conk3r353/YA-SDVX-Con/manufacturing/BOM_YASDVXCon.csv

No. | Quantity | Comment | Designator | Footprint | Value | Manufacturer Part | Manufacturer | Supplier Part | Supplier
1 | 7 | MX1A-11NW | A_BT,B_BT,C_BT,D_BT,FX_L_BT,FX_R_BT,START_BT | SW-TH_MX1A-11NW |  | MX1A-11NW | CHERRY | C3316924 | LCSC
2 | 12 | 100nF | C20,C21,C24,C25,C26,C29,C30,C31,C32,C33,C34,C35 | C0402 | 100nF | CL05B104KO5NNNC | SAMSUNG(三星) | C1525 | LCSC
3 | 2 | 4.7uF | C22,C27 | C0603 | 4.7uF | CL10A475KO8NNNC | SAMSUNG(三星) | C19666 | LCSC
4 | 2 | 1uF | C23,C38 | C0402 | 1uF | CL05A105KA5NQNC | SAMSUNG(三星) | C52923 | LCSC
5 | 1 | 4.7nF | C28 | C1206 | 4.7nF | C1206N472J501TEF | IHHEC(禾伸堂) | C2991917 | LCSC
6 | 2 | 18pF | C36,C37 | C0402 | 18pF | 0402CG180J500NT | FH(风华) | C1549 | LCSC
7 | 1 | USBLC6-2P6 | D2 | SOT-666-6_L1.6-W1.2-P0.50-LS1.6-BR |  | USBLC6-2P6 | ST(意法半导体) | C15999 | LCSC
8 | 1 | HX PH254-01-06-Z-L11.5 through hole header | H1 | HDR-TH_6P-P2.54-V-M |  | HX PH254-01-06-Z-L11.5 through hole header | hanxia(韩下) | C52016393 | LCSC
9 | 1 | GZ2012D601TF | L2 | L0805 |  | GZ2012D601TF | Sunlord(顺络) | C1017 | LCSC
10 | 4 | F.1206.00029/P2-1206B1TS2-09T-201 | LED1,LED2,LED3,LED4 | LED1206-RD |  | F.1206.00029/P2-1206B1TS2-09T-201 | TUOZHAN(拓展光电) | C7496849 | LCSC
11 | 4 | 470Ω | R16,R17,R18,R19 | R0402 | 470Ω | 0402WGF4700TCE | UNI-ROYAL(厚声) | C25117 | LCSC
12 | 3 | 560Ω | R20,R21,R22 | R0603 | 560Ω | 0603WAF5600T5E | UNI-ROYAL(厚声) | C23204 | LCSC
13 | 9 | 10kΩ | R23,R24,R25,R26,R27,R28,R31,R32,R37 | R0402 | 10kΩ | 0402WGF1002TCE | UNI-ROYAL(厚声) | C25744 | LCSC
14 | 2 | 5.1kΩ | R29,R33 | R0402 | 5.1kΩ | 0402WGF5101TCE | UNI-ROYAL(厚声) | C25905 | LCSC
15 | 2 | 22Ω | R30,R34 | R0402 | 22Ω | 0402WGF220JTCE | UNI-ROYAL(厚声) | C25092 | LCSC
16 | 1 | 1MΩ | R35 | R0402 | 1MΩ | 0402WGF1004TCE | UNI-ROYAL(厚声) | C26083 | LCSC
17 | 1 | 1.5kΩ | R36 | R0402 | 1.5kΩ | 0402WGF1501TCE | UNI-ROYAL(厚声) | C25867 | LCSC
18 | 1 | TBD62003AFNG,EL | U8 | SSOP-16_L4.9-W3.9-P0.64-LS6.0-BL |  | TBD62003AFNG,EL | TOSHIBA(东芝) | C150145 | LCSC
19 | 3 | F.1206.00003/P2-1206R1TS2-09T-001 | U10,U11,U12 | LED1206-RD |  | F.1206.00003/P2-1206R1TS2-09T-001 | TUOZHAN(拓展光电) | C7496845 | LCSC
20 | 1 | AP2112K-3.3TRG1 | U15 | SOT-25-5_L2.9-W1.6-P0.95-LS2.8-BL |  | AP2112K-3.3TRG1 | DIODES(美台) | C51118 | LCSC
21 | 1 | STM32F303RET6 | U16 | LQFP-64_L10.0-W10.0-P0.50-LS12.0-BL |  | STM32F303RET6 | ST(意法半导体) | C183214 | LCSC
22 | 1 | TYPE-C-31-M-12 | USBC2 | USB-C_SMD-TYPE-C-31-M-12_1 |  | TYPE-C-31-M-12 | 韩国韩荣 | C165948 | LCSC
23 | 2 | PEC16-4020F-N0024 | VOL_L,VOL_R | SW-SMD_PEC16-4120F-N0012 |  | PEC16-4020F-N0024 | BOURNS | C22402301 | JLCPCB
24 | 1 | 8MHz | X2 | CRYSTAL-SMD_4P-L3.2-W2.5-BL | 8MHz | X32258MOB4SI | YXC(扬兴晶振) | C2682775 | LCSC
