conk3r353/YA-SDVX-Con/manufacturing/case/pcb_case_plates_1-3.dxf

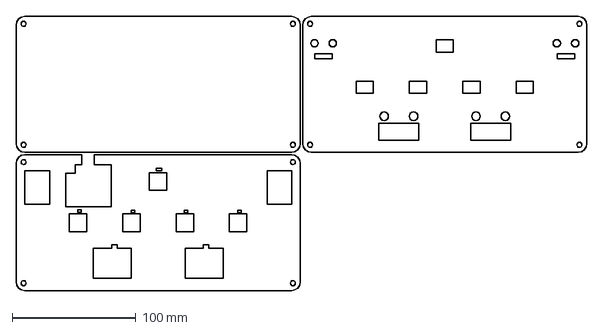
[picture p3: CAD file, 2026-09-15]
manufacturing/case/pcb_case_plates_1-3.dxf
462.0 x 222.0 mm
