conk3r353/YA-SDVX-Con/manufacturing/case/pcb_case_plates_extra_info.dxf

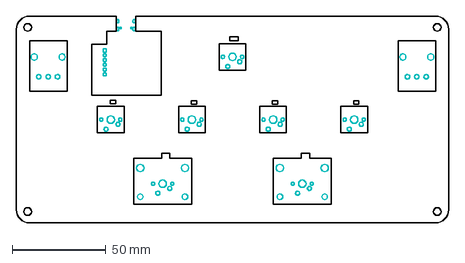
[picture p4: CAD file, 2026-09-15]
manufacturing/case/pcb_case_plates_extra_info.dxf
230.0 x 110.0 mm
