conk3r353/YA-SDVX-Con/manufacturing/case/pcb_case_plate_4.dxf

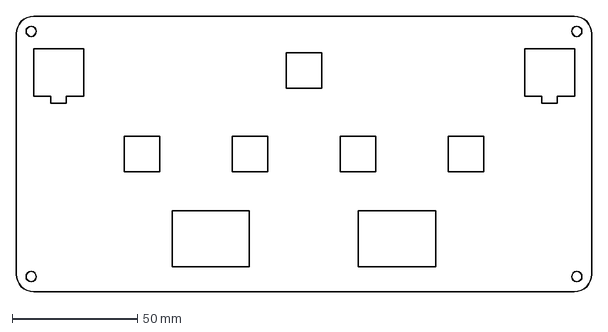
[picture p5: CAD file, 2026-09-13]
manufacturing/case/pcb_case_plate_4.dxf
230.0 x 110.0 mm
