conk3r353/YA-SDVX-Con/software/Core/Src/main.c

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
/* Includes ------------------------------------------------------------------*/
#include "main.h"
#include "usb_device.h"

/* USER CODE BEGIN Includes */
#include "usbd_customhid.h"
#include "Button.h"
/* USER CODE END Includes */

TIM_HandleTypeDef htim2;
TIM_HandleTypeDef htim3;

UART_HandleTypeDef huart2;

/* USER CODE BEGIN PV */
extern PCD_HandleTypeDef hpcd_USB_FS;
extern USBD_HandleTypeDef hUsbDeviceFS;

volatile uint16_t vol_l_counter = 0;
volatile uint16_t vol_r_counter = 0;

volatile Button bt_a;
volatile Button bt_b;
volatile Button bt_c;
volatile Button bt_d;
volatile Button bt_fx_l;
volatile Button bt_fx_r;
volatile Button bt_start;

volatile GPIO_PinState bt_a_state = GPIO_PIN_RESET;
volatile GPIO_PinState bt_b_state = GPIO_PIN_RESET;
volatile GPIO_PinState bt_c_state = GPIO_PIN_RESET;
volatile GPIO_PinState bt_d_state = GPIO_PIN_RESET;
volatile GPIO_PinState bt_fx_l_state = GPIO_PIN_RESET;
volatile GPIO_PinState bt_fx_r_state = GPIO_PIN_RESET;
volatile GPIO_PinState bt_start_state = GPIO_PIN_RESET;

typedef struct __attribute__((packed)) {
    uint8_t report_id;
    uint16_t buttons;
    uint8_t vol_l_encoder;
    uint8_t vol_r_encoder;
} HID_Report_t;

HID_Report_t hid_report = {0};
/* USER CODE END PV */

void SystemClock_Config(void);
static void MX_GPIO_Init(void);
static void MX_USART2_UART_Init(void);
static void MX_TIM2_Init(void);
static void MX_TIM3_Init(void);
/**
  * @brief  The application entry point.
  * @retval int
  */
int main(void)
{

  /* MCU Configuration--------------------------------------------------------*/

  /* Reset of all peripherals, Initializes the Flash interface and the Systick. */
  HAL_Init();

  /* Configure the system clock */
  SystemClock_Config();

  /* Initialize all configured peripherals */
  MX_GPIO_Init();
  MX_USART2_UART_Init();
  MX_TIM2_Init();
  MX_TIM3_Init();

  MX_USB_DEVICE_Init();
  /* USER CODE BEGIN 2 */

  HAL_TIM_Encoder_Start(&htim2, TIM_CHANNEL_ALL);
  HAL_TIM_Encoder_Start(&htim3, TIM_CHANNEL_ALL);

  bt_a = Button_Init(DEFAULT_DEBOUNCE);
  bt_b = Button_Init(DEFAULT_DEBOUNCE);
  bt_c = Button_Init(DEFAULT_DEBOUNCE);
  bt_d = Button_Init(DEFAULT_DEBOUNCE);
  bt_fx_l = Button_Init(DEFAULT_DEBOUNCE);
  bt_fx_r = Button_Init(DEFAULT_DEBOUNCE);
  bt_start = Button_Init(DEFAULT_DEBOUNCE);

  /* USER CODE END 2 */

  /* Infinite loop */
  /* USER CODE BEGIN WHILE */
  while (1)
  {
    /* USER CODE END WHILE */
	  __WFI();
    /* USER CODE BEGIN 3 */
  }
  /* USER CODE END 3 */
}

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
/* USER CODE BEGIN 4 */
void Process_SOF_Callback() {
  hid_report.report_id = 0x04;
  hid_report.buttons = 0x00;

  bt_a_state = Update_Button(&bt_a, HAL_GPIO_ReadPin(A_BT_GPIO_Port, A_BT_Pin));
  hid_report.buttons |= ((!bt_a_state) << 0);
  bt_b_state = Update_Button(&bt_b, HAL_GPIO_ReadPin(B_BT_GPIO_Port, B_BT_Pin));
  hid_report.buttons |= ((!bt_b_state) << 1);
  bt_c_state = Update_Button(&bt_c, HAL_GPIO_ReadPin(C_BT_GPIO_Port, C_BT_Pin));
  hid_report.buttons |= ((!bt_c_state) << 2);
  bt_d_state = Update_Button(&bt_d, HAL_GPIO_ReadPin(D_BT_GPIO_Port, D_BT_Pin));
  hid_report.buttons |= ((!bt_d_state) << 3);
  bt_fx_l_state = Update_Button(&bt_fx_l, HAL_GPIO_ReadPin(FX_L_BT_GPIO_Port, FX_L_BT_Pin));
  hid_report.buttons |= ((!bt_fx_l_state) << 4);
  bt_fx_r_state = Update_Button(&bt_fx_r, HAL_GPIO_ReadPin(FX_R_BT_GPIO_Port, FX_R_BT_Pin));
  hid_report.buttons |= ((!bt_fx_r_state) << 5);
  bt_start_state = Update_Button(&bt_start, HAL_GPIO_ReadPin(START_BT_GPIO_Port, START_BT_Pin));
  hid_report.buttons |= ((!bt_start_state) << 8);

  HAL_GPIO_WritePin(A_BT_LED_GPIO_Port, A_BT_LED_Pin, !bt_a_state);
  HAL_GPIO_WritePin(B_BT_LED_GPIO_Port, B_BT_LED_Pin, !bt_b_state);
  HAL_GPIO_WritePin(C_BT_LED_GPIO_Port, C_BT_LED_Pin, !bt_c_state);
  HAL_GPIO_WritePin(D_BT_LED_GPIO_Port, D_BT_LED_Pin, !bt_d_state);
  HAL_GPIO_WritePin(FX_L_BT_LED_GPIO_Port, FX_L_BT_LED_Pin, !bt_fx_l_state);
  HAL_GPIO_WritePin(FX_R_BT_LED_GPIO_Port, FX_R_BT_LED_Pin, !bt_fx_r_state);
  HAL_GPIO_WritePin(START_BT_LED_GPIO_Port, START_BT_LED_Pin, !bt_start_state);

  vol_l_counter = __HAL_TIM_GET_COUNTER(&htim2);
  hid_report.vol_l_encoder = (uint8_t)(((uint32_t)(vol_l_counter % 48u) * 255u) / 48u);

  vol_r_counter = __HAL_TIM_GET_COUNTER(&htim3);
  hid_report.vol_r_encoder = (uint8_t)(((uint32_t)(vol_r_counter % 48u) * 255u) / 48u);

  USBD_CUSTOM_HID_HandleTypeDef *hhid = (USBD_CUSTOM_HID_HandleTypeDef*)hUsbDeviceFS.pClassData;
  if (hhid->state == CUSTOM_HID_IDLE)
  {
    USBD_CUSTOM_HID_SendReport(&hUsbDeviceFS, (uint8_t*)&hid_report, sizeof(hid_report));
  }
}

/* USER CODE END 4 */
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
