conk3r353/YA-SDVX-Con/software/YASDVXController.ioc

Mcu.UserName=STM32F303RETx
PA0.GPIO_Label=VOL_L_CH1
PA0.Signal=S_TIM2_CH1_ETR
PA1.GPIO_Label=VOL_L_CH2
PA1.Signal=S_TIM2_CH2
PA11.Signal=USB_DM
PA12.Signal=USB_DP
PA13.GPIO_Label=TMS
PA13.Signal=SYS_JTMS-SWDIO
PA14.GPIO_Label=TCK
PA14.Signal=SYS_JTCK-SWCLK
PA2.GPIO_Label=USART_TX
PA2.Signal=USART2_TX
PA3.GPIO_Label=USART_RX
PA3.Signal=USART2_RX
PA6.GPIO_Label=VOL_R_CH1
PA6.Signal=S_TIM3_CH1
PA7.GPIO_Label=VOL_R_CH2
PA7.Signal=S_TIM3_CH2
PB0.GPIO_Label=C_BT
PB0.Signal=GPIO_Input
PB1.GPIO_Label=D_BT
PB1.Signal=GPIO_Input
PB10.GPIO_Label=FX_R_BT
PB10.Signal=GPIO_Input
PB11.GPIO_Label=START_BT
PB11.Signal=GPIO_Input
PB12.GPIO_Label=START_BT_LED
PB12.Signal=GPIO_Output
PB13.GPIO_Label=FX_R_BT_LED
PB13.Signal=GPIO_Output
PB14.GPIO_Label=FX_L_BT_LED
PB14.Signal=GPIO_Output
PB15.GPIO_Label=D_BT_LED
PB15.Signal=GPIO_Output
PB2.GPIO_Label=FX_L_BT
PB2.Signal=GPIO_Input
PC4.GPIO_Label=A_BT
PC4.Signal=GPIO_Input
PC5.GPIO_Label=B_BT
PC5.Signal=GPIO_Input
PC6.GPIO_Label=C_BT_LED
PC6.Signal=GPIO_Output
PC7.GPIO_Label=B_BT_LED
PC7.Signal=GPIO_Output
PC8.GPIO_Label=A_BT_LED
PC8.Signal=GPIO_Output
PF0-OSC_IN.Signal=RCC_OSC_IN
PF1-OSC_OUT.Signal=RCC_OSC_OUT
