conk3r353/YA-SDVX-Con/software/Core/Inc/main.h

#define VOL_L_CH1_Pin GPIO_PIN_0
#define VOL_L_CH1_GPIO_Port GPIOA
#define VOL_L_CH2_Pin GPIO_PIN_1
#define VOL_L_CH2_GPIO_Port GPIOA
#define USART_TX_Pin GPIO_PIN_2
#define USART_TX_GPIO_Port GPIOA
#define USART_RX_Pin GPIO_PIN_3
#define USART_RX_GPIO_Port GPIOA
#define VOL_R_CH1_Pin GPIO_PIN_6
#define VOL_R_CH1_GPIO_Port GPIOA
#define VOL_R_CH2_Pin GPIO_PIN_7
#define VOL_R_CH2_GPIO_Port GPIOA
#define A_BT_Pin GPIO_PIN_4
#define A_BT_GPIO_Port GPIOC
#define B_BT_Pin GPIO_PIN_5
#define B_BT_GPIO_Port GPIOC
#define C_BT_Pin GPIO_PIN_0
#define C_BT_GPIO_Port GPIOB
#define D_BT_Pin GPIO_PIN_1
#define D_BT_GPIO_Port GPIOB
#define FX_L_BT_Pin GPIO_PIN_2
#define FX_L_BT_GPIO_Port GPIOB
#define FX_R_BT_Pin GPIO_PIN_10
#define FX_R_BT_GPIO_Port GPIOB
#define START_BT_Pin GPIO_PIN_11
#define START_BT_GPIO_Port GPIOB
#define START_BT_LED_Pin GPIO_PIN_12
#define START_BT_LED_GPIO_Port GPIOB
#define FX_R_BT_LED_Pin GPIO_PIN_13
#define FX_R_BT_LED_GPIO_Port GPIOB
#define FX_L_BT_LED_Pin GPIO_PIN_14
#define FX_L_BT_LED_GPIO_Port GPIOB
#define D_BT_LED_Pin GPIO_PIN_15
#define D_BT_LED_GPIO_Port GPIOB
#define C_BT_LED_Pin GPIO_PIN_6
#define C_BT_LED_GPIO_Port GPIOC
#define B_BT_LED_Pin GPIO_PIN_7
#define B_BT_LED_GPIO_Port GPIOC
#define A_BT_LED_Pin GPIO_PIN_8
#define A_BT_LED_GPIO_Port GPIOC
#define TMS_Pin GPIO_PIN_13
#define TMS_GPIO_Port GPIOA
#define TCK_Pin GPIO_PIN_14
#define TCK_GPIO_Port GPIOA
