conk3r353/YA-SDVX-Con/(commit log)

2026-09-11 fixed encoder rotation jumps
2026-09-13 added acryllic case design
2026-09-15 add case DXF file with extra info for easier modification
2026-09-15 cleaned pcb_case_plates_1-3.dxf
2026-09-16 added more docs about switches, encoders and stabilizers
